RawiNoun/WROFutEng-Mindscape-2026/docs/obstacle-challenge-flowchart.png

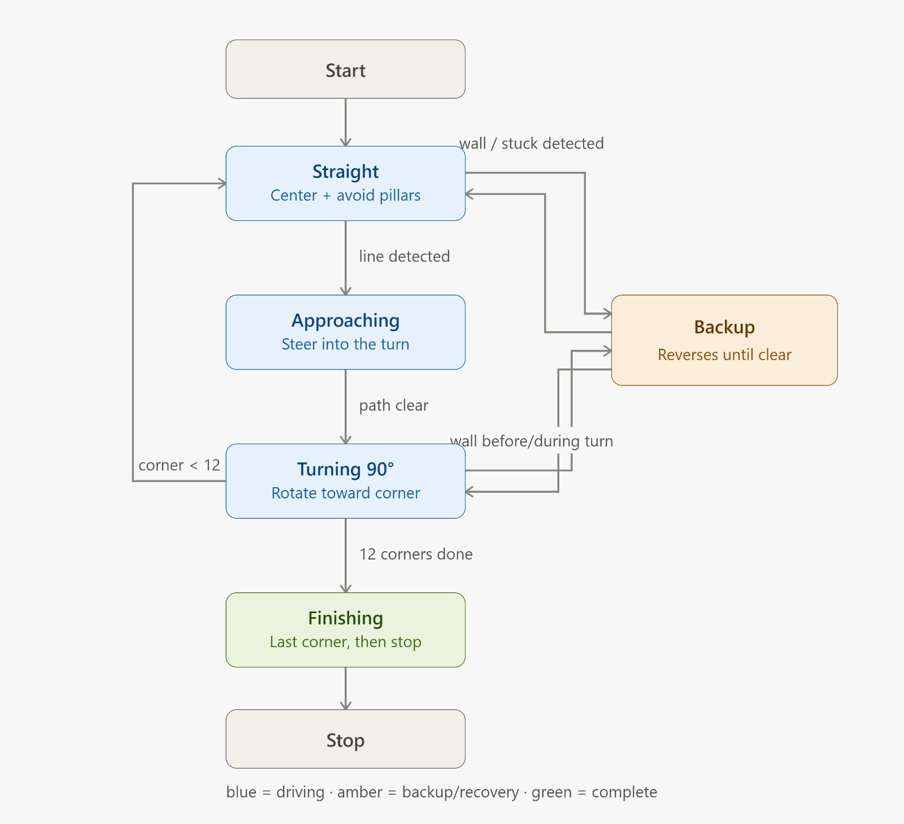
docs/obstacle-challenge-flowchart.png
