RawiNoun/WROFutEng-Mindscape-2026/docs/open-challenge-flowchart.png

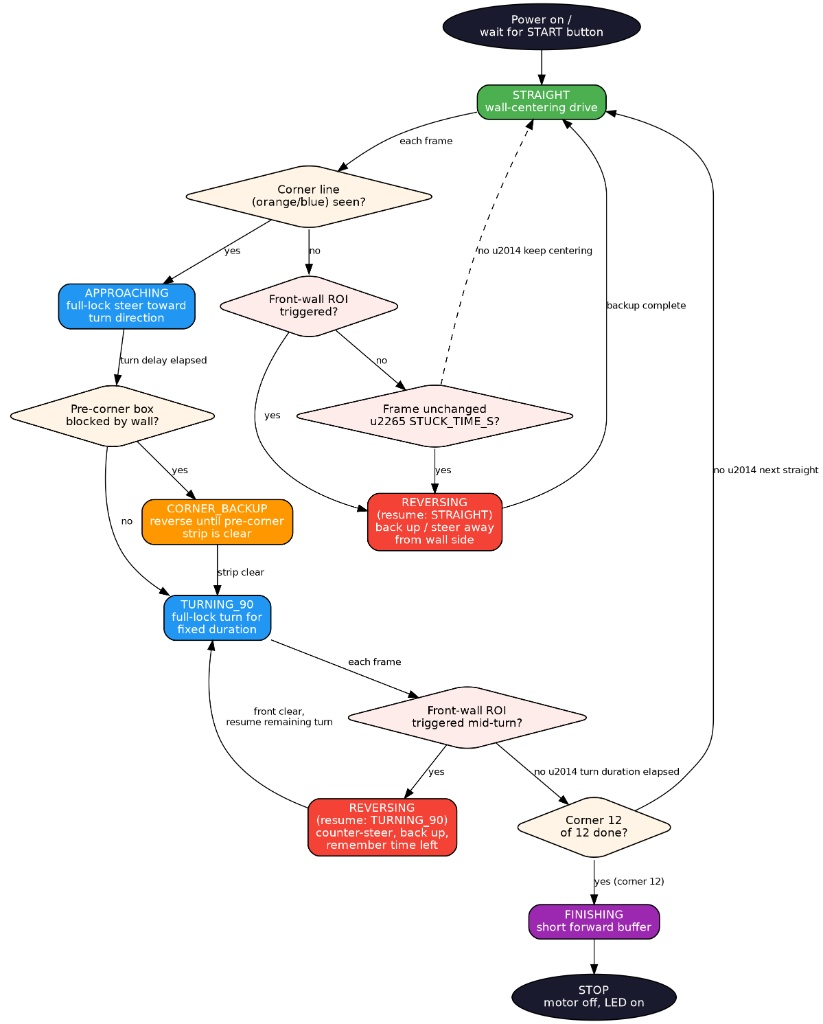
docs/open-challenge-flowchart.png
