RawiNoun/WROFutEng-Mindscape-2026/hardware/cad-files/version2/v2.png

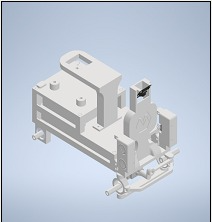
hardware/cad-files/version2/v2.png
