RawiNoun/WROFutEng-Mindscape-2026/media/robot-photos/version2/back.png

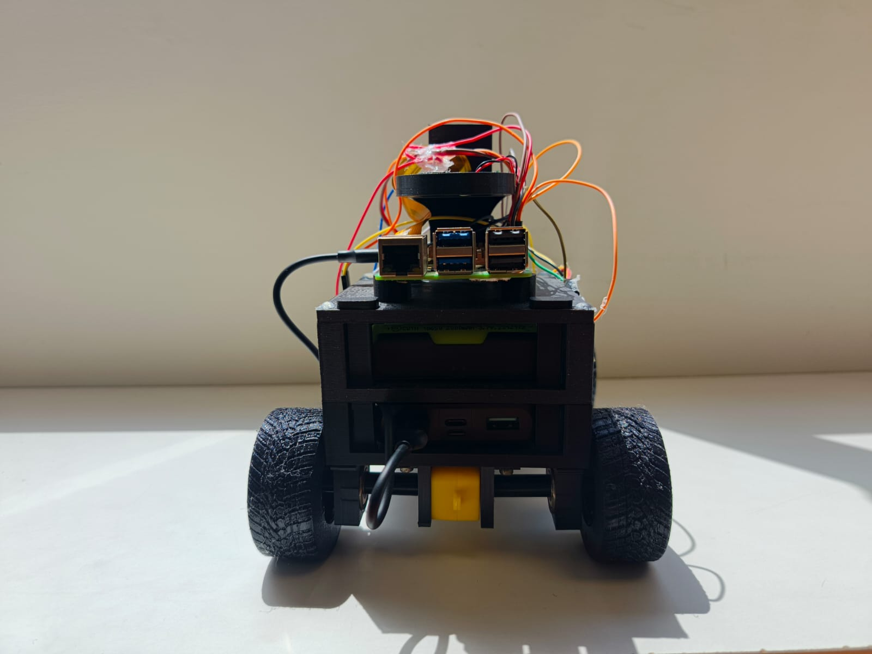
media/robot-photos/version2/back.png
