RawiNoun/WROFutEng-Mindscape-2026/media/robot-photos/version2/bottom.png

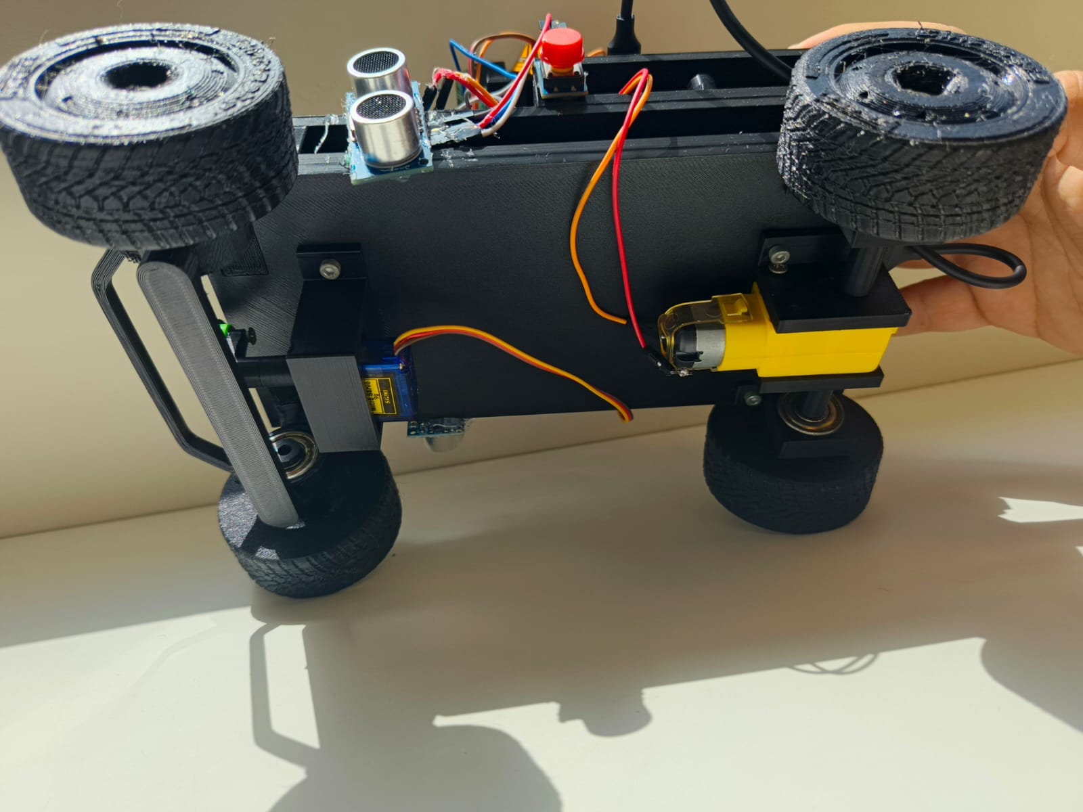
media/robot-photos/version2/bottom.png
