RawiNoun/WROFutEng-Mindscape-2026/media/robot-photos/version2/front.png

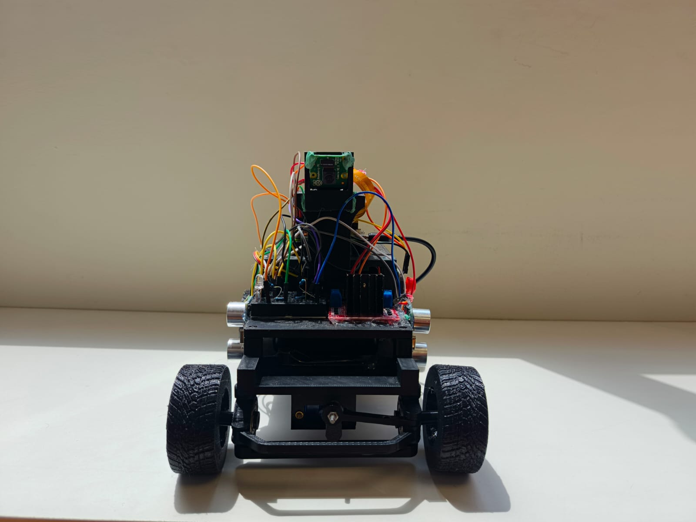
media/robot-photos/version2/front.png
