RawiNoun/WROFutEng-Mindscape-2026/media/robot-photos/version2/right.png

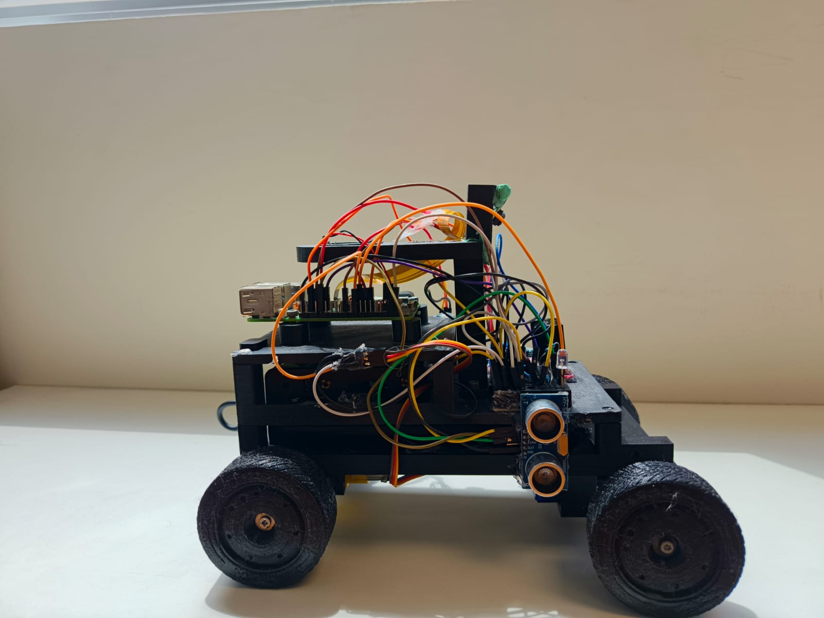
media/robot-photos/version2/right.png
