RawiNoun/WROFutEng-Mindscape-2026/media/robot-photos/version2/top.png

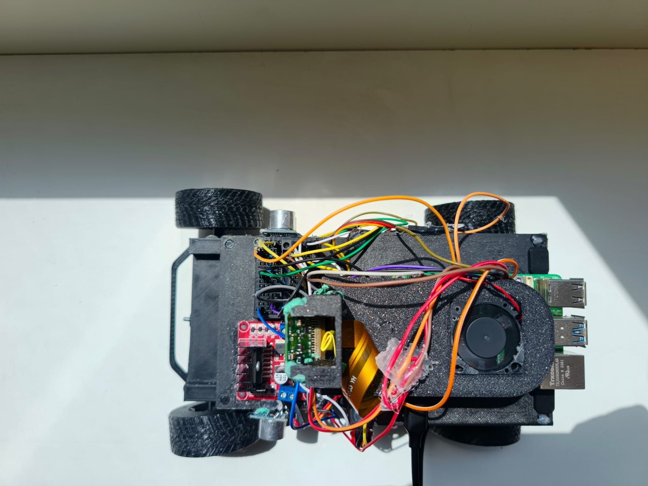
media/robot-photos/version2/top.png
