RawiNoun/WROFutEng-Mindscape-2026/media/team-photos/funny-photo.png

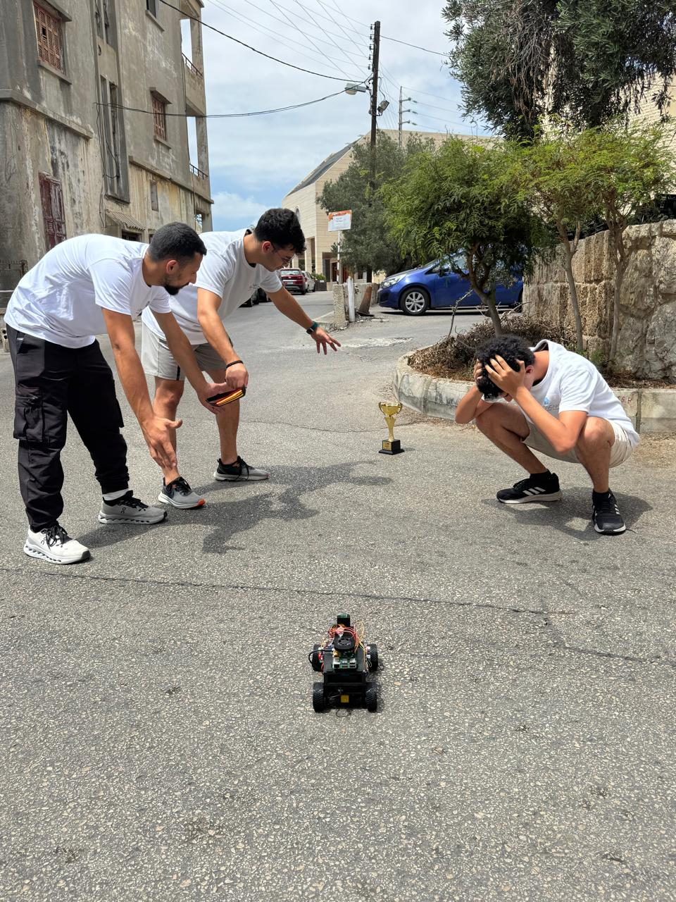
media/team-photos/funny-photo.png
