RawiNoun/WROFutEng-Mindscape-2026/media/team-photos/official-photo.png

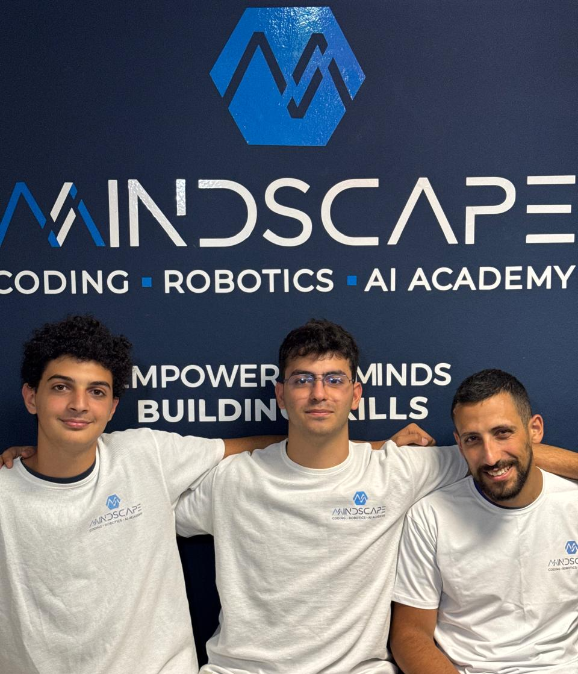
media/team-photos/official-photo.png
