RawiNoun/WROFutEng-Mindscape-2026/(list of files, cad)

Other CAD files:
hardware/cad-files/version1/v1.iam
hardware/cad-files/version2/v2.iam
