RawiNoun/WROFutEng-Mindscape-2026/docs/WRO26 wirings.png

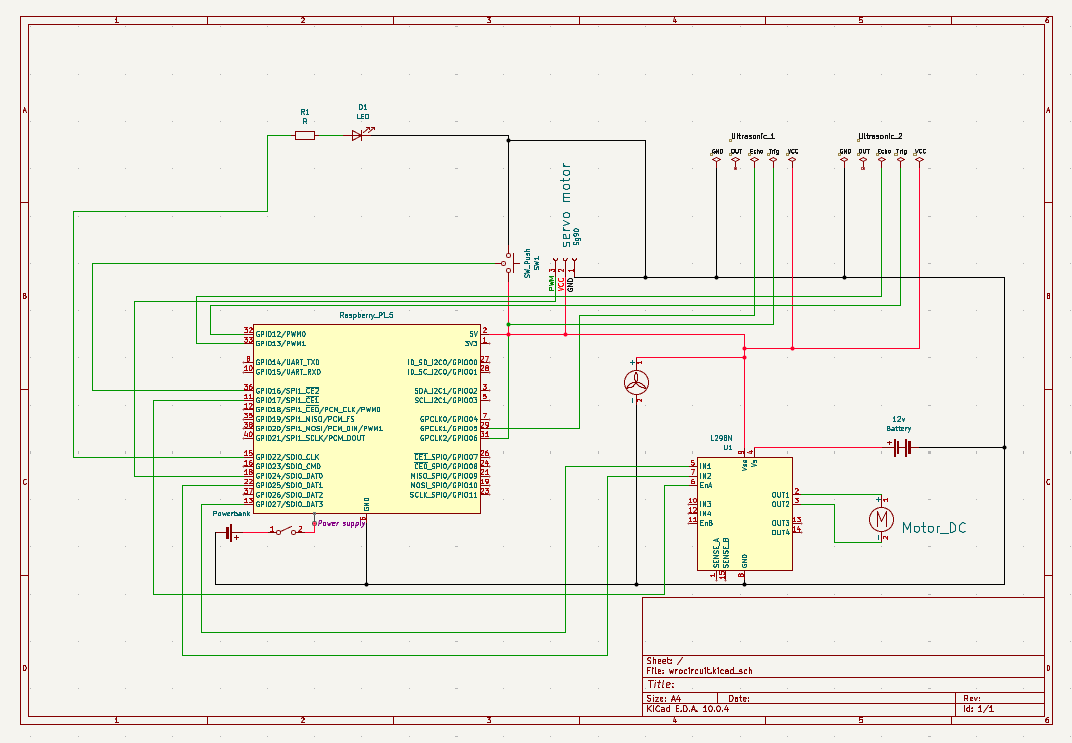
docs/WRO26 wirings.png
