RawiNoun/WROFutEng-Mindscape-2026/hardware/wiring-files/camera wiring.png

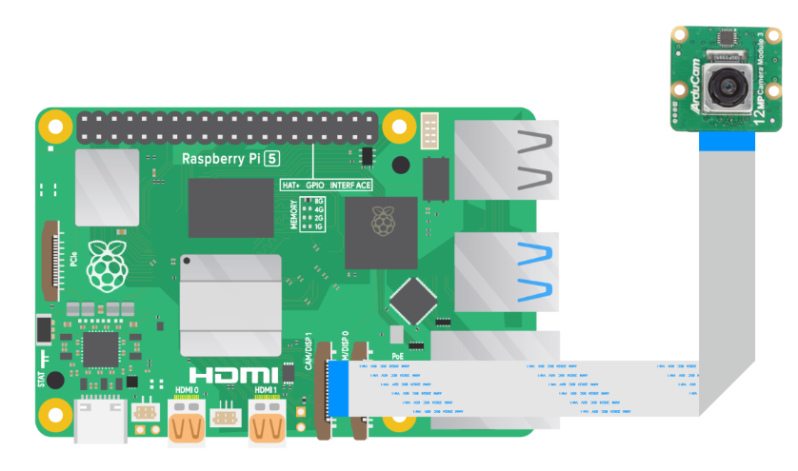
hardware/wiring-files/camera wiring.png
