RawiNoun/WROFutEng-Mindscape-2026/src/open_challenge/camera_config.py

# camera_config.py

WIDTH = 640
HEIGHT = 480

MAIN_FORMAT = "XRGB8888"
LORES_FORMAT = "XRGB8888"

USE_LARGEST_SENSOR_MODE = True
MAX_FOV = True
PREVIEW_TYPE = "QTGL"


EXPOSURE_TIME = 9000
AE_ENABLE = False
ANALOGUE_GAIN = 2.0
