RawiNoun/WROFutEng-Mindscape-2026/tests/color_config.py

# color_config.py

import numpy as np

LOWER_RED1 = np.array([0, 120, 70])
UPPER_RED1 = np.array([10, 255, 255])

LOWER_RED2 = np.array([170, 120, 70])
UPPER_RED2 = np.array([180, 255, 255])

LOWER_GREEN = np.array([35, 70, 70])
UPPER_GREEN = np.array([90, 255, 255])

# BLACK WALLS
LOWER_BLACK = np.array([0, 0, 0])
UPPER_BLACK = np.array([180, 255, 55])

MIN_AREA = 700
MIN_WALL_AREA = 900

ALPHA = 1.15
BETA = 8
