RawiNoun/WROFutEng-Mindscape-2026/(commit log)

2026-07-10 Added 3d models of the first version
    [Assembly1.iam]
2026-07-15 repo structure
    [Assembly1.iam]
2026-07-18 added components and wiring diagrams
2026-07-21 added cad files for versions 1 and 2 and added pictures of the robot from all angles
    [v1.iam, v2.iam]
2026-07-24 added testing logs/results, engineering journal, flowchart for open challenge and wiring pictures
